F4DCA/esp32-solder/(commit log)

2026-11-06 ESP32-C3 T12 station: control core, native simulation, build setup
    - lib/control: HAL-independent PID (parallel form, derivative on
    measurement, conditional-integration anti-windup) and a 1st-order
    thermal plant, compiled by both the host sim and the firmware
    - src/sim_main.cpp: 100 Hz harness, 30 s setpoint step 26 -> 350 C,
    writes a 7-column CSV
    - src/main.cpp: firmware entry stub
    - tools/plot_step.py: dependency-free step-response metrics, ASCII
    plot and SVG output
    - platformio.ini: env:native for the host sim, platform pinned by URL
    - README.md: overview, verified sim numbers, timing constraint, parts
    - reference/: third-party firmware and schematics, reference only
    [SolderingStation2_BOM_v2.4.tsv, SolderingStation2_BOM_v2.5.tsv, SolderingStation2_BOM_v2.6.tsv, SolderingStation2_BOM_v2.7.tsv, SolderingStationV2_knob.fcstd, SolderingStationV2_knob.stl, SolderungStationV2_Case_ESD.fcstd, SolderungStationV2_Case_ESD.stl]
2026-11-06 Move the station onto ESPHome with an interlocked 100 Hz frame
    The frame scheduler, the heater-off measurement window and the front-end
    calibration move into lib/control, so the host simulation runs the same code as
    the firmware. The PID takes a new-sample flag and a sample interval, which
    refreshes the derivative at 20 Hz while the loop runs at 100 Hz.
    The firmware is an ESPHome config plus a t12 component that owns the ADS1115
    read, the software PWM, the encoder menu and the OLED layout from the sketch in
    reference/. lib/control is built in place through a file:// library, so there
    is still one copy of the control code.
    The Arduino entry stub and the ESP32 environment are gone; env:nativ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
